dlandry8/Romulator/references_and_articles/RemoteLabSystem/WFA2_wontOpenInVS2010/WindowsFormsApplication2/WindowsFormsApplication2/Resources/radioshack_ir.jpg

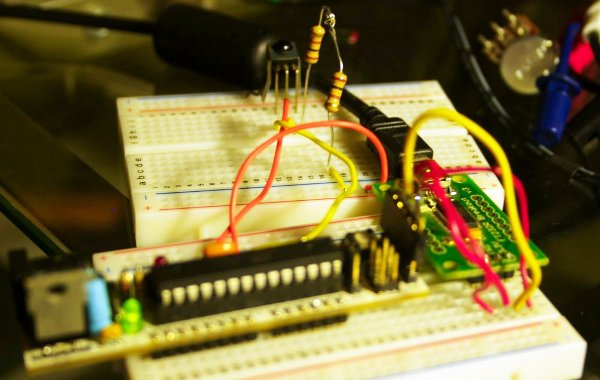
references_and_articles/RemoteLabSystem/WFA2_wontOpenInVS2010/WindowsFormsApplication2/WindowsFormsApplication2/Resources/radioshack_ir.jpg
