dlandry8/Romulator/schematics_and_PCBs/readme.txt

This folder mainly contains screen shots of our schematic. The schematic and PCB were designed using ExpressSchematic and
ExpressPCB, a free download.
