dlandry8/Romulator/code_files/Arduino/romArd/readme.txt

romArd.h contains a listing of constants and function headers for romArd.ino.
romArd.ino is the main sketch to be uploaded to the Arduino Mega.
