dlandry8/Romulator/Flowcharts/Arduino Initialize.png

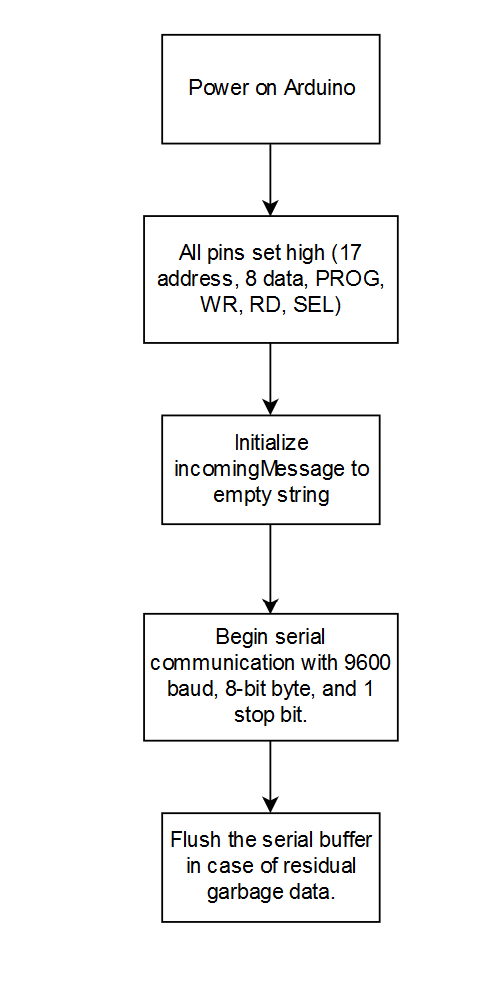
Flowcharts/Arduino Initialize.png
