dlandry8/Romulator/Flowcharts/Emulate Flowchart.png

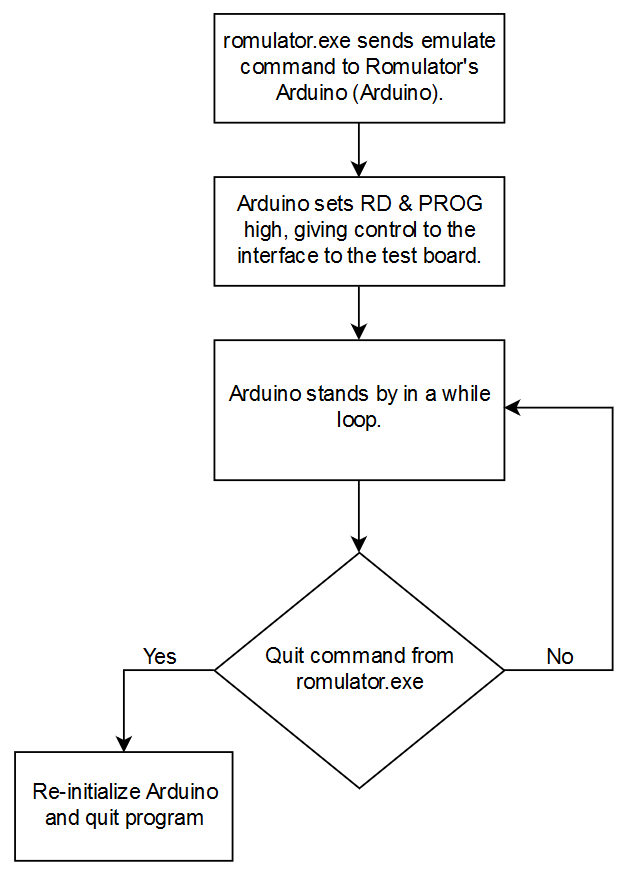
Flowcharts/Emulate Flowchart.png
