dlandry8/Romulator/Flowcharts/Interface Flowchart.png

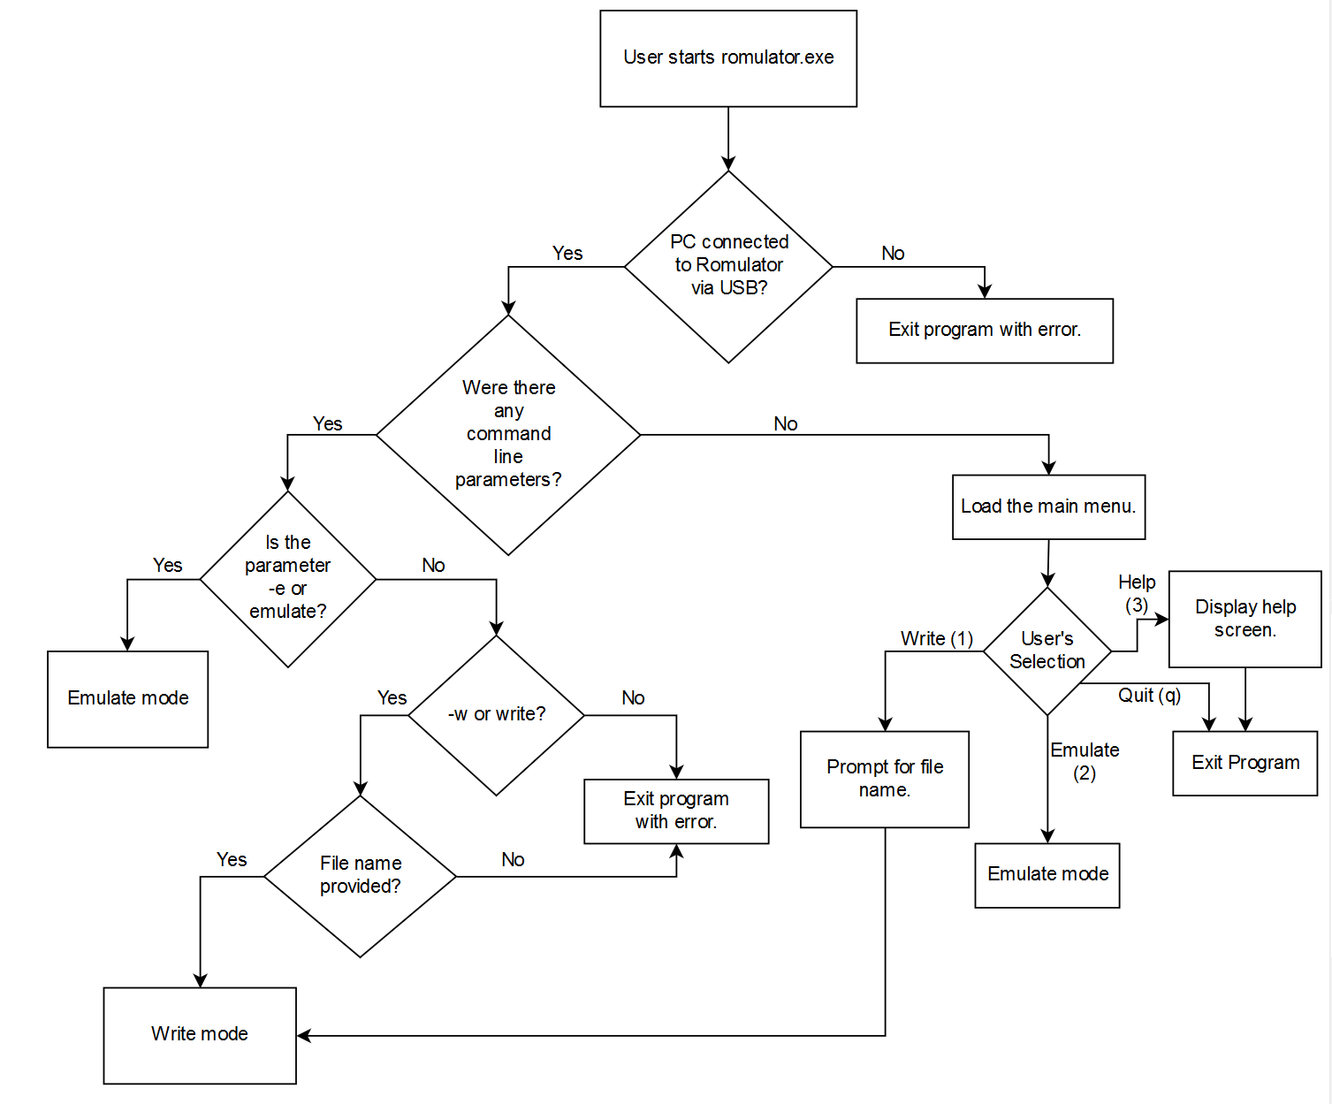
Flowcharts/Interface Flowchart.png
