dlandry8/Romulator/Flowcharts/Write Flowchart.png

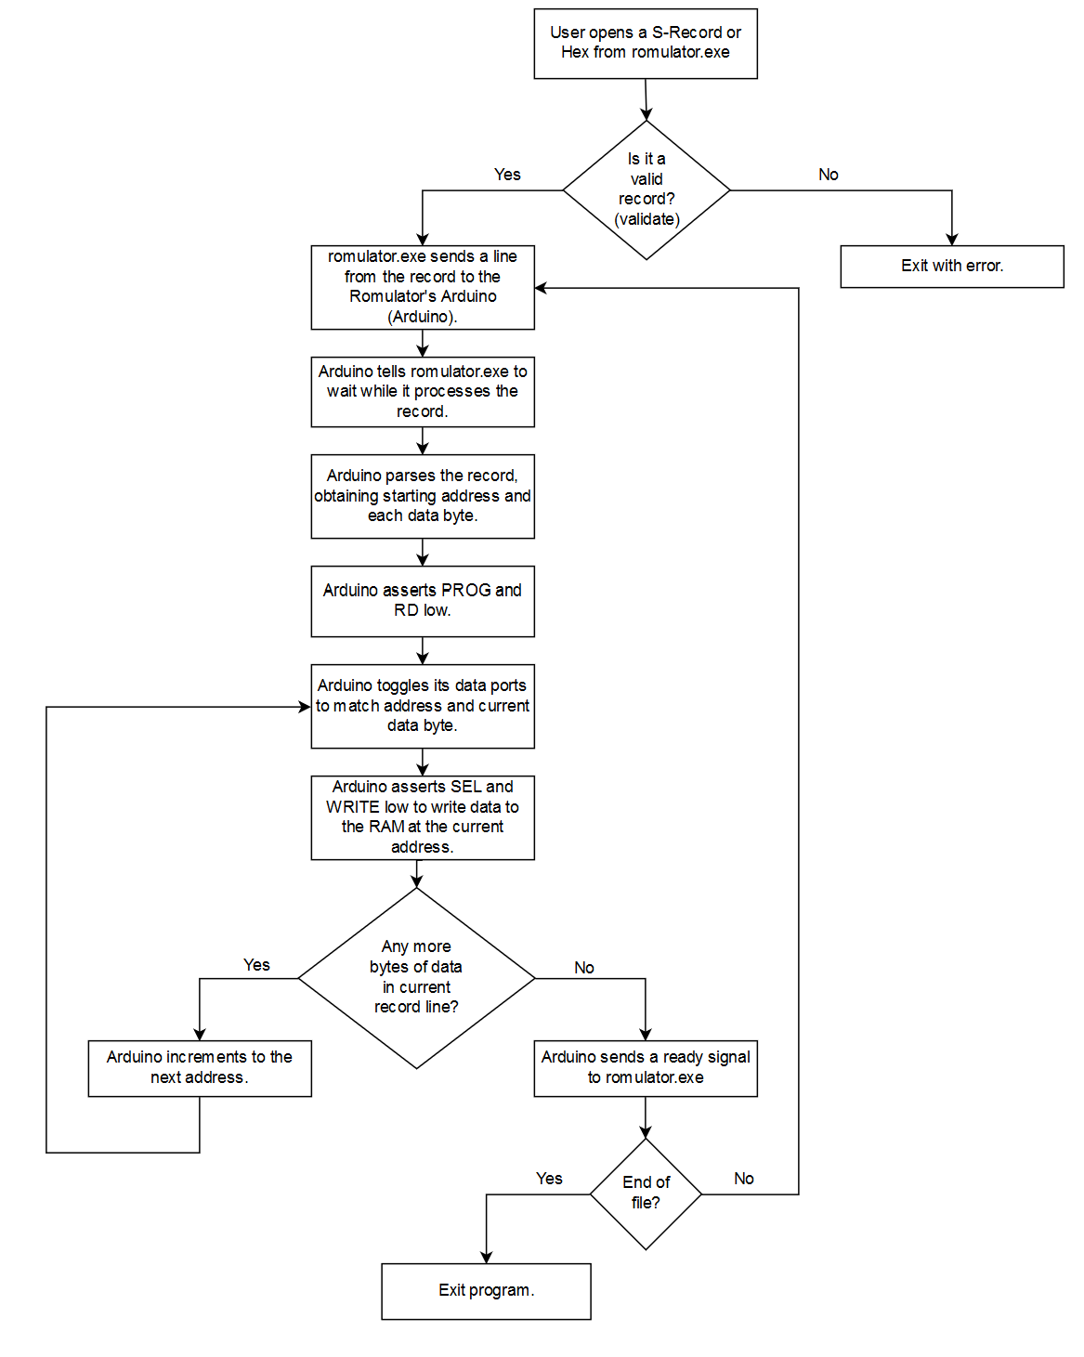
Flowcharts/Write Flowchart.png
