dlandry8/Romulator/references_and_articles/RemoteLabSystem/WFA2_wontOpenInVS2010/WindowsFormsApplication2/WindowsFormsApplication2/Resources/DB001.png

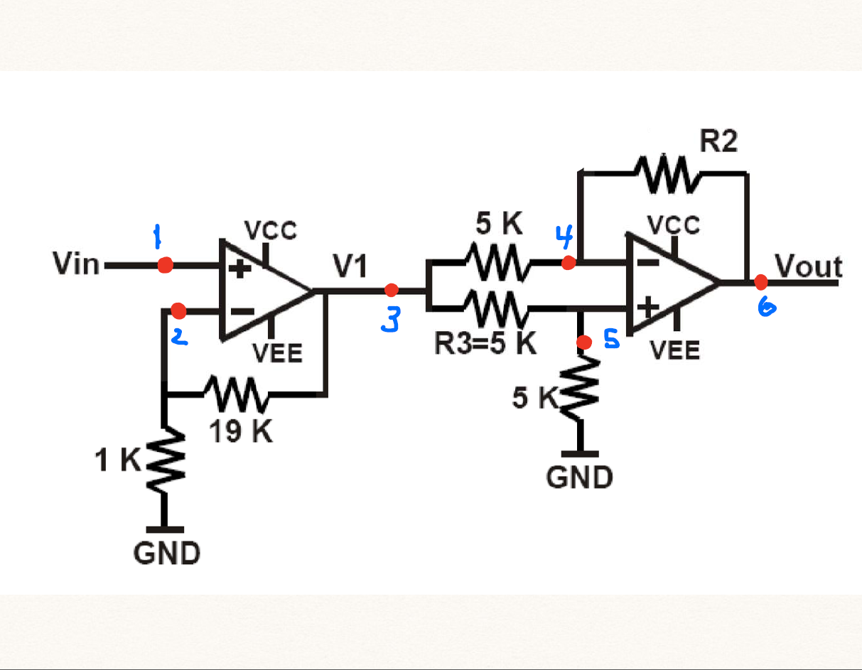
references_and_articles/RemoteLabSystem/WFA2_wontOpenInVS2010/WindowsFormsApplication2/WindowsFormsApplication2/Resources/DB001.png
