dlandry8/Romulator/schematics_and_PCBs/Romulator Address Buffers Corrected.png

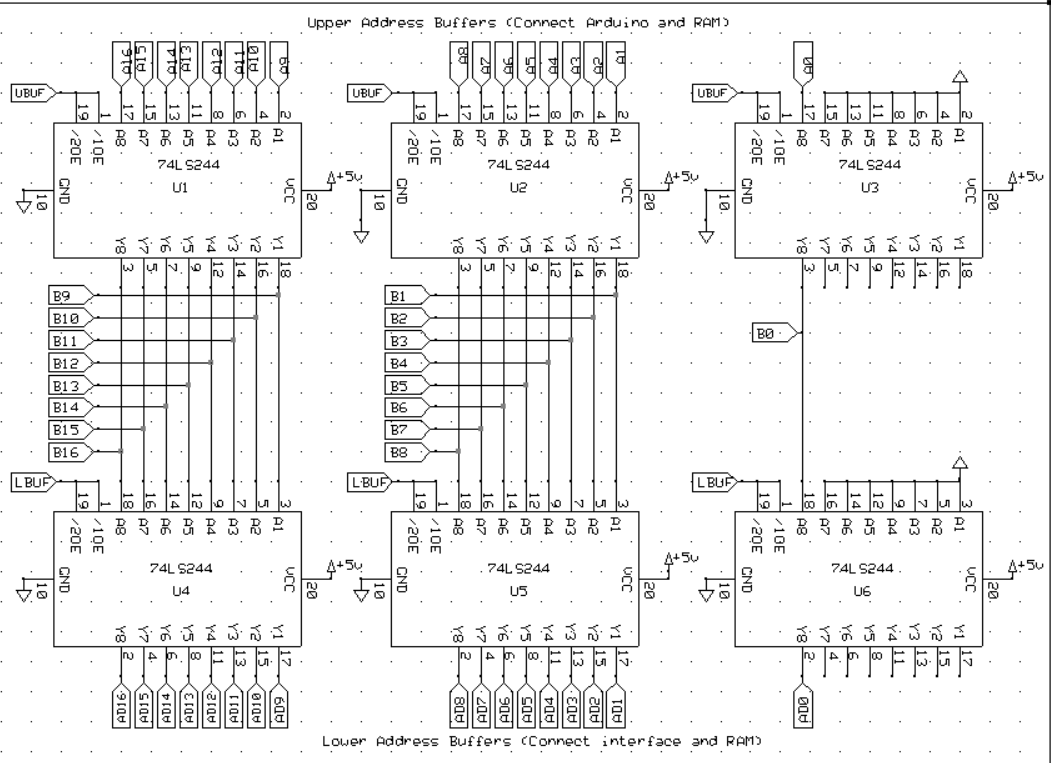
schematics_and_PCBs/Romulator Address Buffers Corrected.png
