dlandry8/Romulator/schematics_and_PCBs/Romulator Arduino RAM Interface.bmp

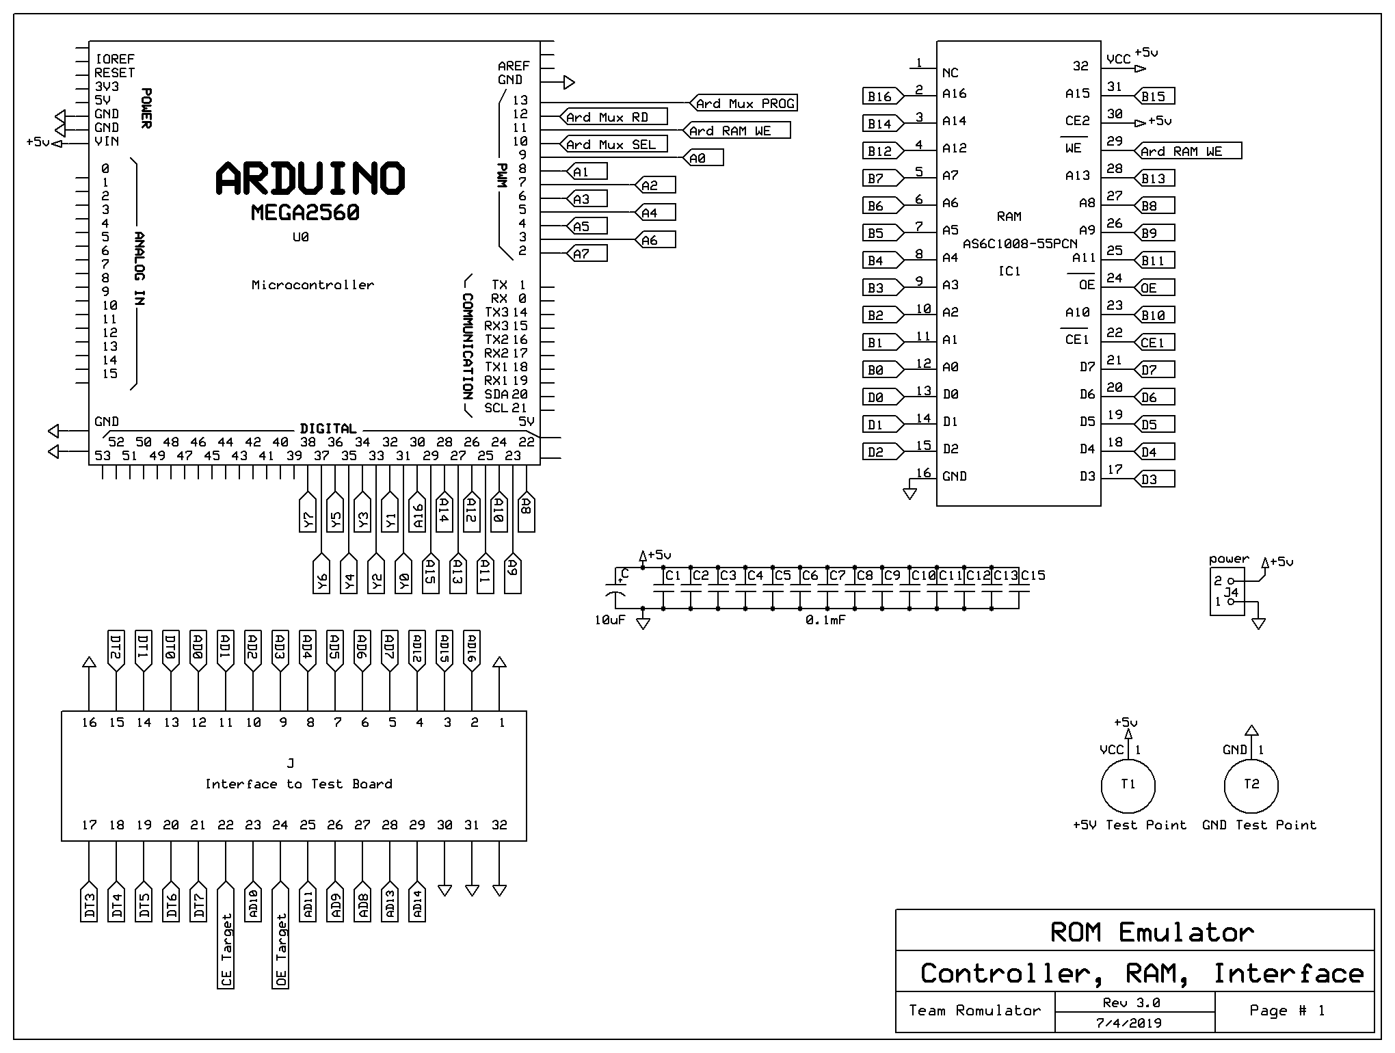
schematics_and_PCBs/Romulator Arduino RAM Interface.bmp
