dlandry8/Romulator/schematics_and_PCBs/Romulator Arduino RAM Interface.jpg

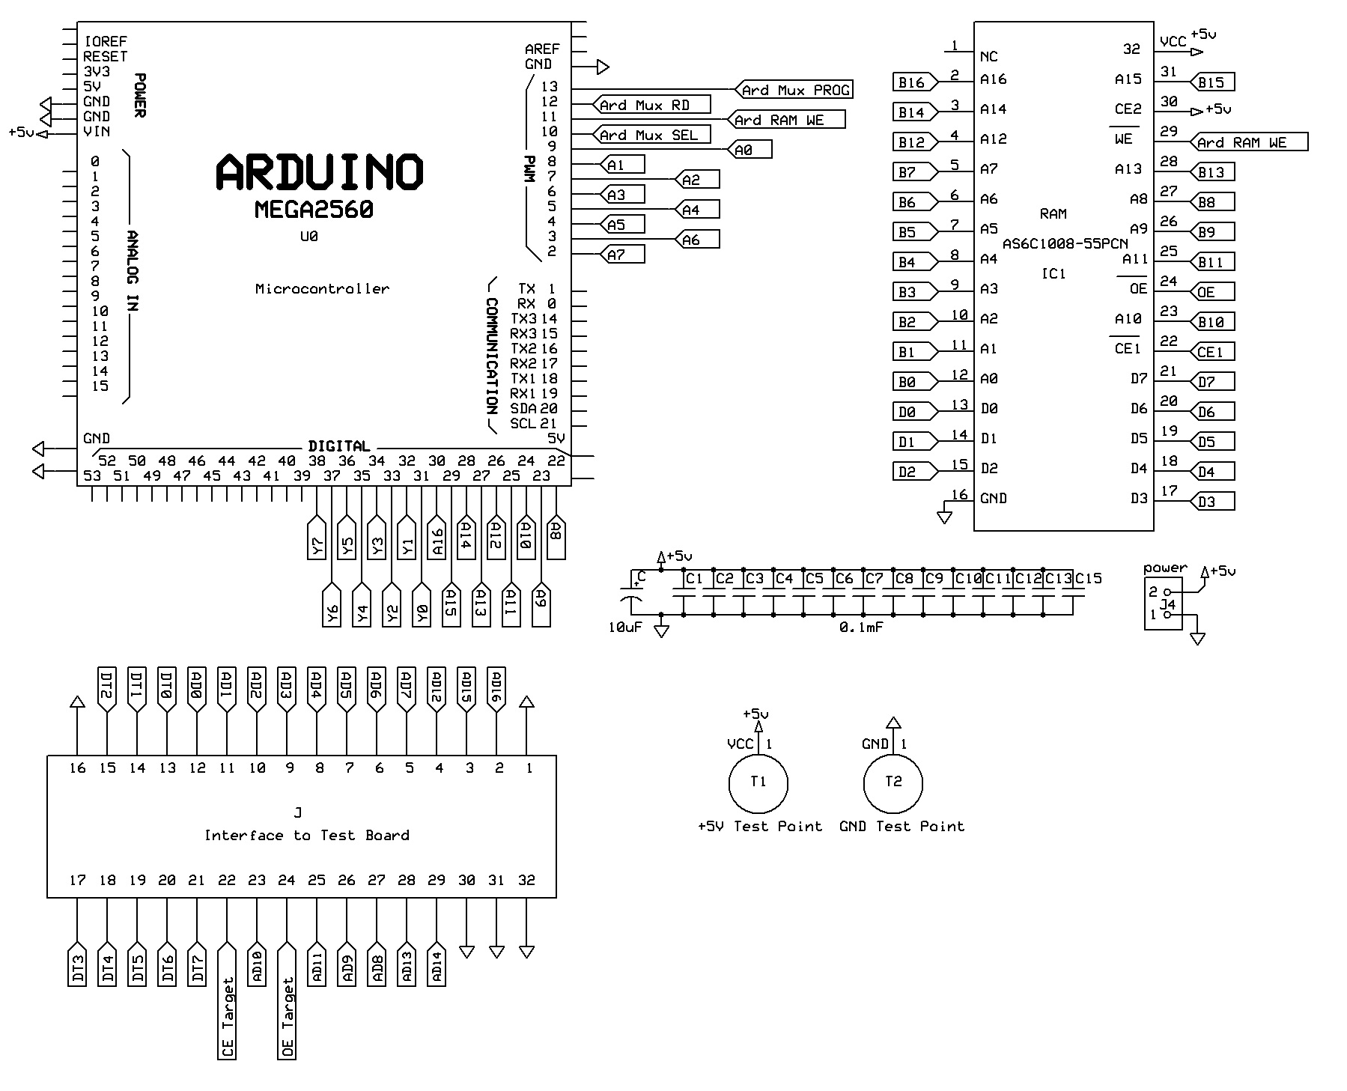
schematics_and_PCBs/Romulator Arduino RAM Interface.jpg
