dlandry8/Romulator/schematics_and_PCBs/Romulator Buffers Control.bmp

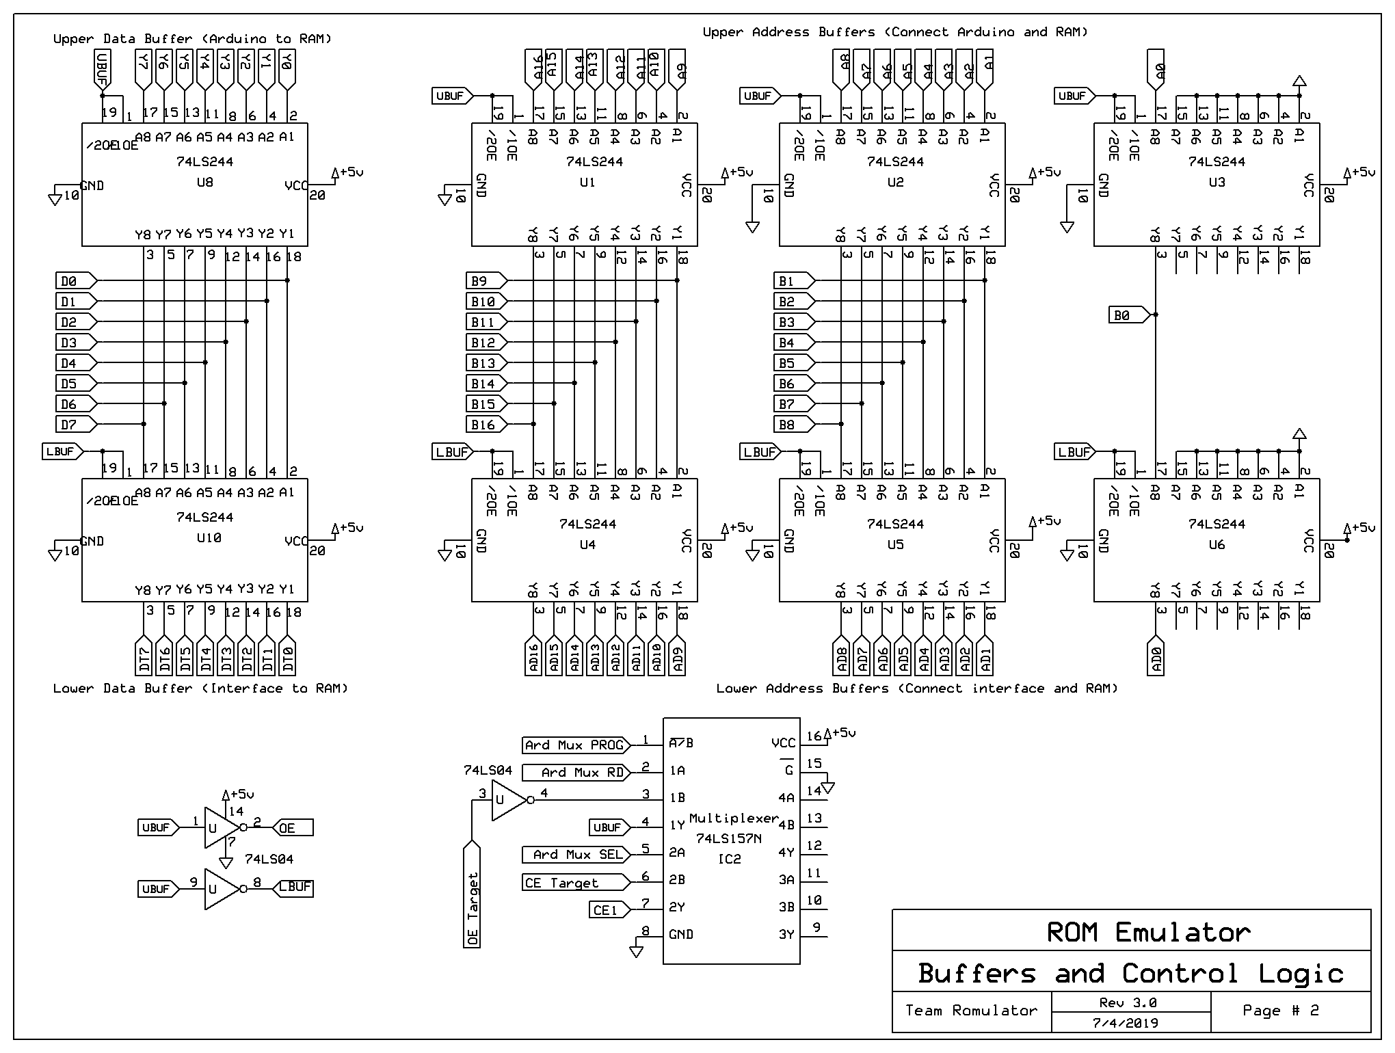
schematics_and_PCBs/Romulator Buffers Control.bmp
