dlandry8/Romulator/schematics_and_PCBs/Romulator Data Buffers.png

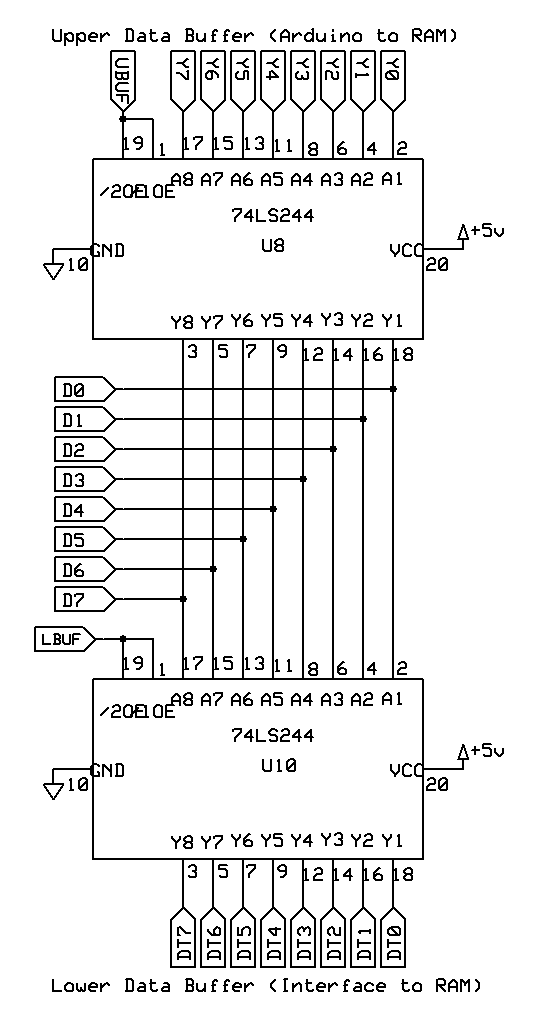
schematics_and_PCBs/Romulator Data Buffers.png
