dlandry8/Romulator/schematics_and_PCBs/Romulator glue logic.png

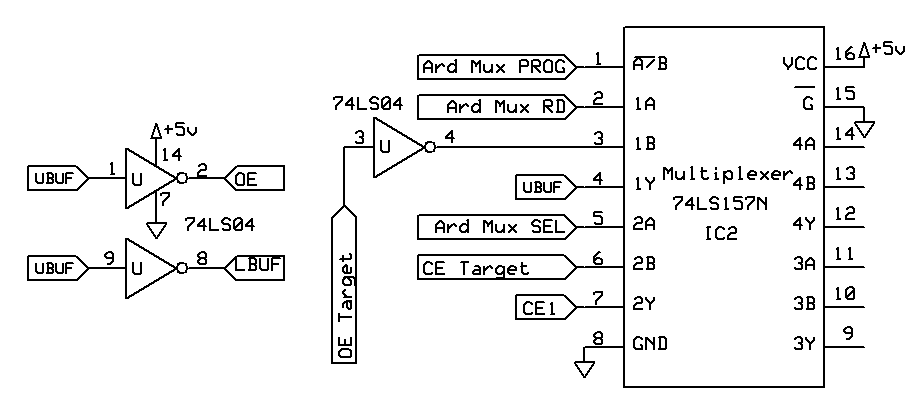
schematics_and_PCBs/Romulator glue logic.png
