dlandry8/Romulator/schematics_and_PCBs/Romulator PCB.png

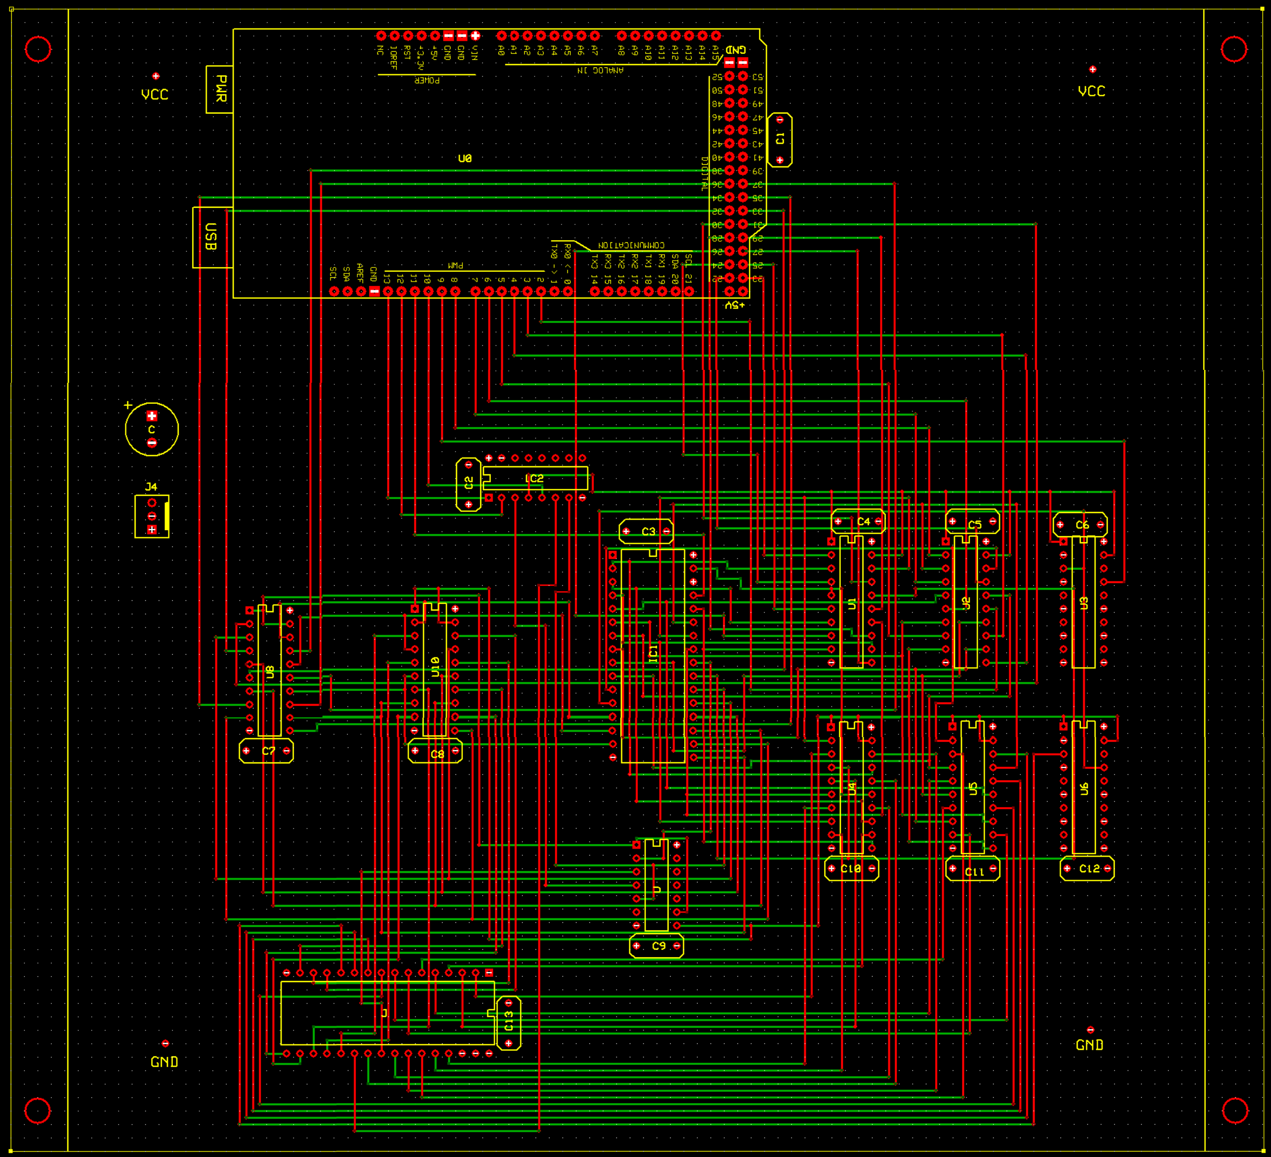
schematics_and_PCBs/Romulator PCB.png
