dlandry8/Romulator/Flowcharts/Software Flowcharts Rev 2-Validate.png

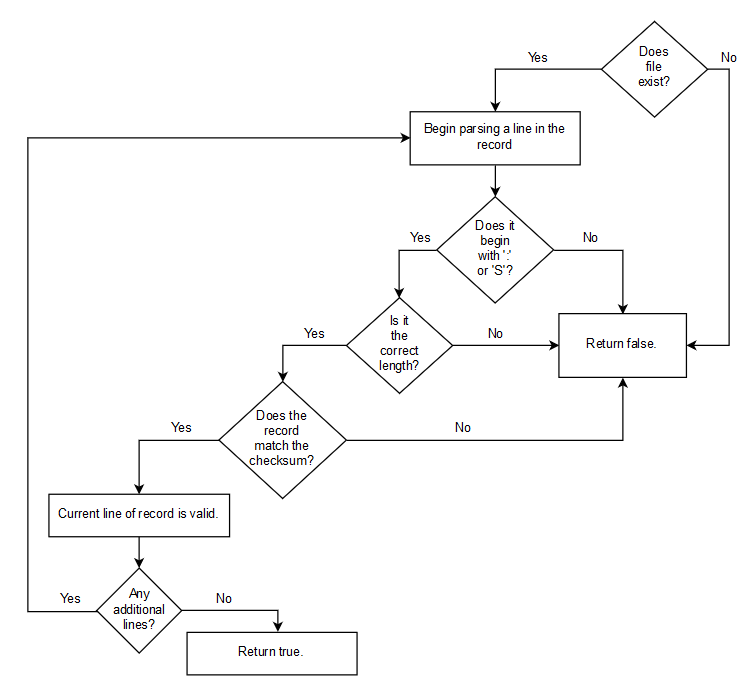
Flowcharts/Software Flowcharts Rev 2-Validate.png
