dlandry8/Romulator/references_and_articles/M03233009.pdf

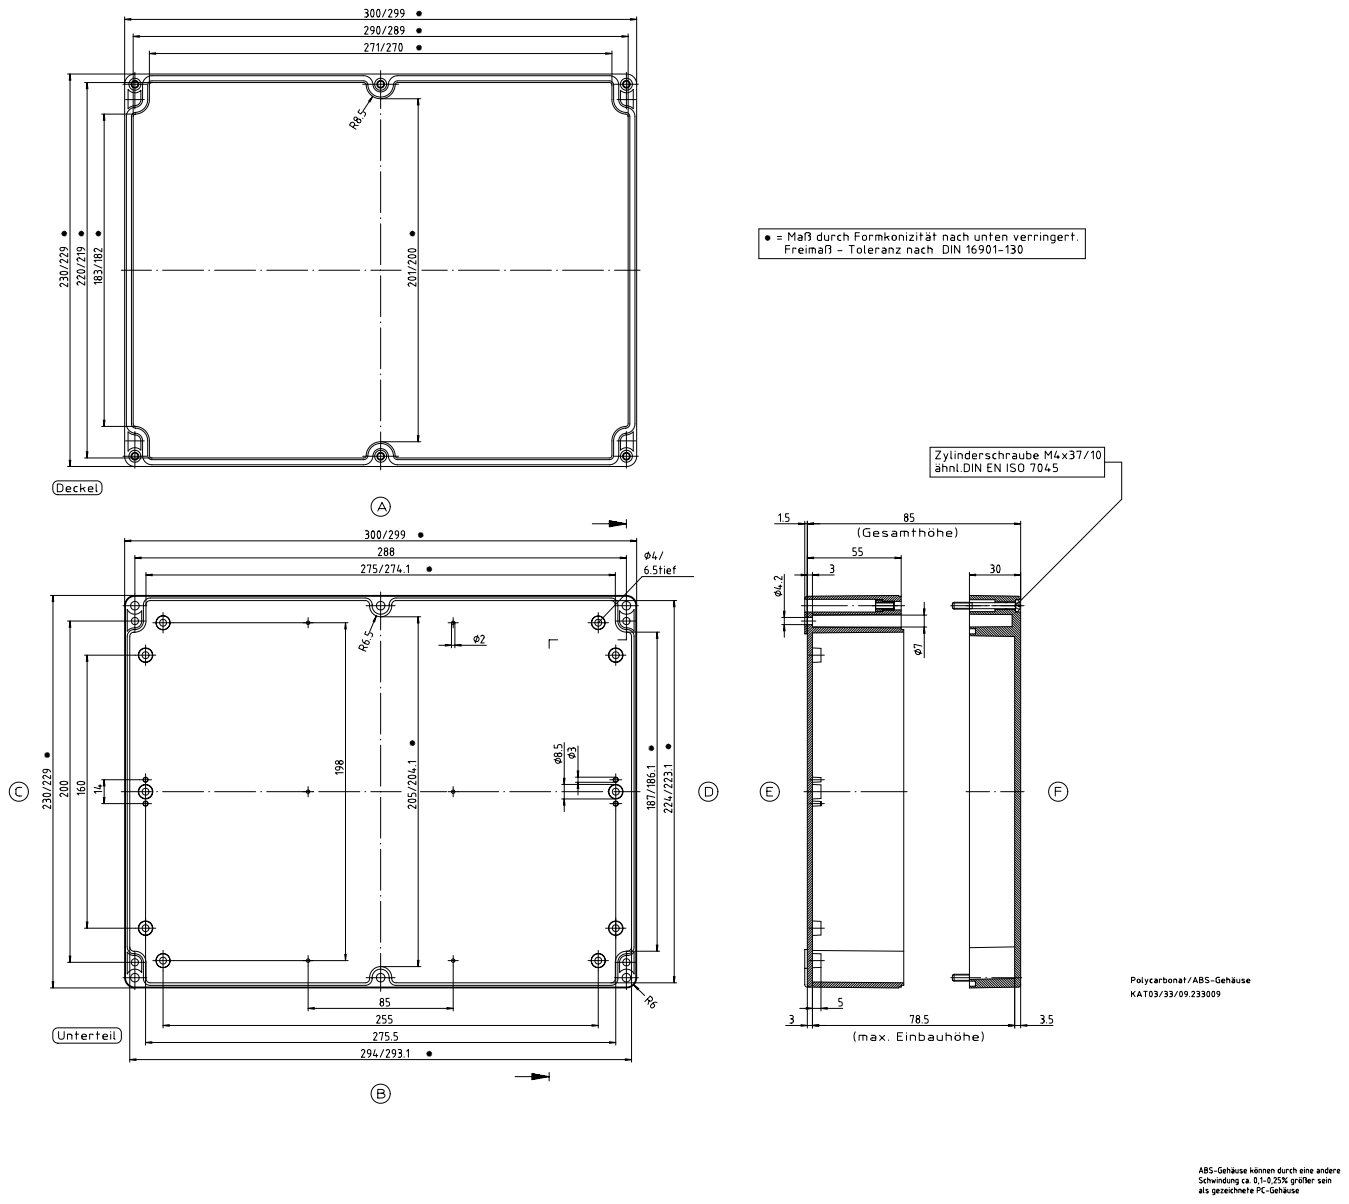
[picture p15: page 1]
