dlandry8/Romulator/(list of files, drawings)

Other design files:
old/Schematic and PCB/Romulator 2 (1).pcb
old/Schematic and PCB/Romulator 2 -new.pcb
old/Schematic and PCB/Romulator 2.pcb
old/Schematic and PCB/Romulator Rev 3b.pcb
old/Schematic and PCB/Romulator Unmodified.pcb
schematics_and_PCBs/Adapter for Arduino Rev 2.pcb
schematics_and_PCBs/Romulator Alt Design.pcb
schematics_and_PCBs/Romulator Rev 4.pcb
