dlandry8/Romulator/(commit log)

2019-08-22 updated Romulator
    [ATMega Pin Map.xlsx, Adapter for Arduino Rev 2.pcb, Gantt Chart Rev 4.xlsx, Gantt Chart Rev 5.xlsx, Gantt Chart Rev 6.xlsx, Gantt Chart Rev 7.xlsx, Rommulator 555.sch, Romulator 2 (1).pcb]
2019-08-22 Update schematic and PCB
    Deleted old files. Renamed some files to make them easier to understand. Added a screenshot of the corrected address buffer layout.
    [Rommulator 555.sch, Romulator 2 (1).pcb, Romulator 2 -new.pcb, Romulator 2.pcb, Romulator Alt Design.pcb, Romulator Rev 3-2.sch, Romulator Rev 3.sch, Romulator Rev 3b.pcb]
2019-08-22 cleanup
    Removed loose files that were not relevant to the submitted project.
    [romulator1.CSV]
2019-08-22 add old schematics
    Added old versions of schematic to track project progress
    [Rommulator 555.sch, Romulator 2 (1).pcb, Romulator 2 -new.pcb, Romulator 2.pcb, Romulator Rev 3-2.sch, Romulator Rev 3.sch, Romulator Rev 3b.pcb, Romulator Unmodified.pcb]
2020-02-25 add powerpoint presentation of our ROM emulator
2020-02-25 upload the ROM emulator power point presentation
2021-12-17 rename files for ease of access from a command line
    [ATMega Pin Map.xlsx, Adapter for Arduino Rev 2.pcb, Gantt Chart Rev 4.xlsx, Gantt Chart Rev 5.xlsx, Gantt Chart Rev 6.xlsx, Gantt Chart Rev 7.xlsx, Romulator Alt Design.pcb, Romulator Correction.sch]
